ostojaatanasijevic/DS100M08KV2/README.md

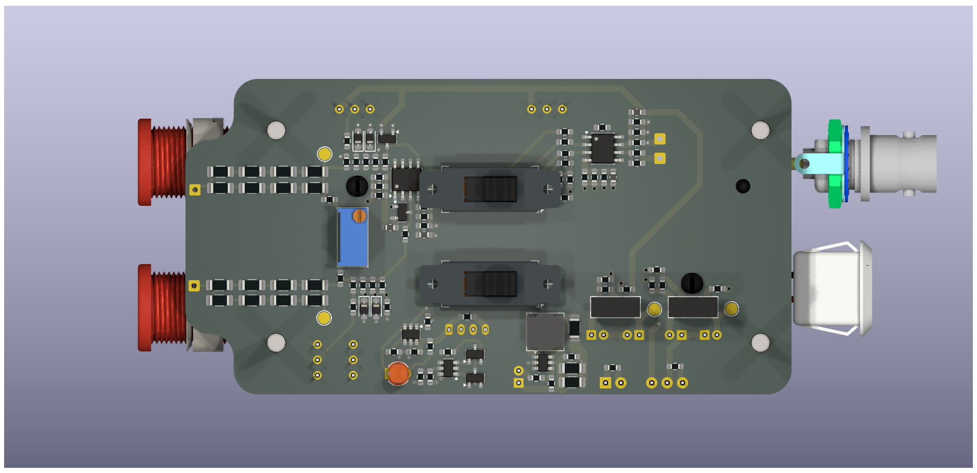
[picture p1: DS100M08KV_top.png]
3D_top

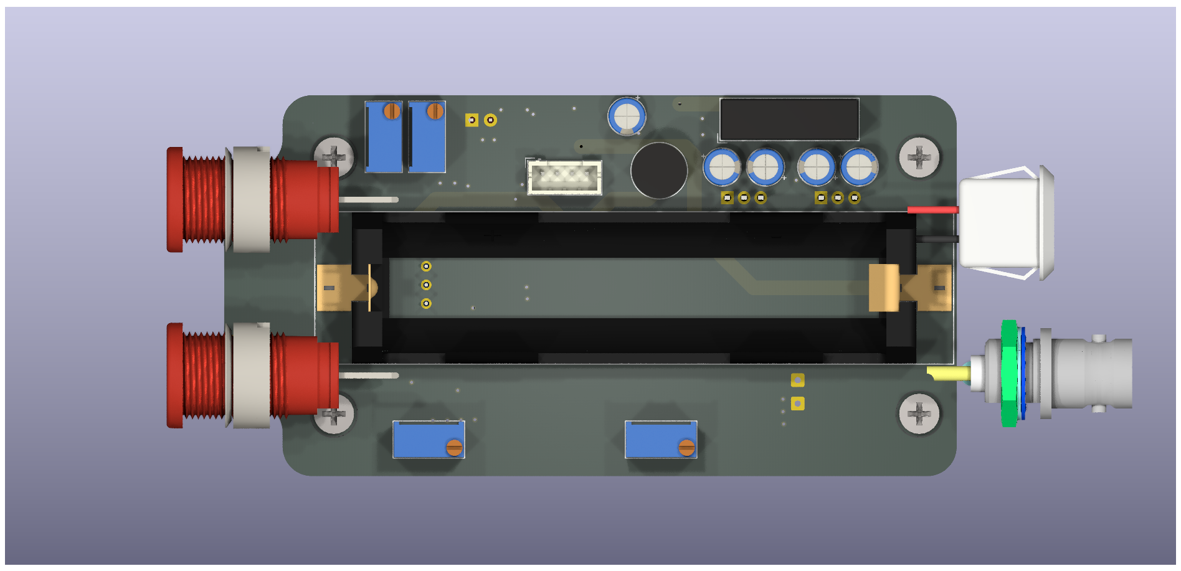
[picture p2: DS100M08KV_bottom.png]
3D_bottom

schematic
