ostojaatanasijevic/DS100M08KV2/documentation/figs/3d_view_top.png

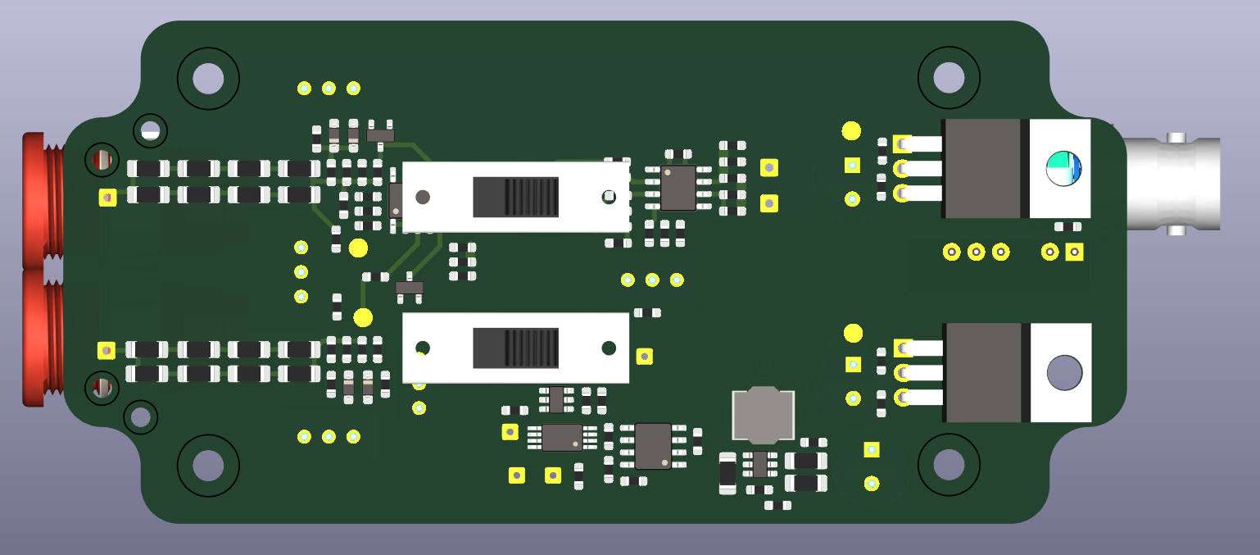
documentation/figs/3d_view_top.png
