ostojaatanasijevic/DS100M08KV2/documentation/figs/case.png

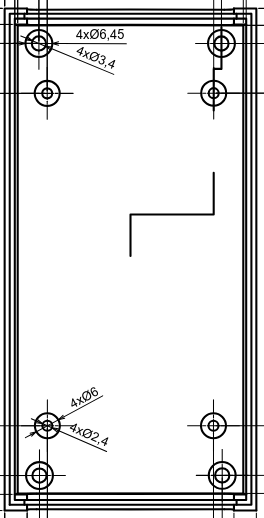
documentation/figs/case.png
