ostojaatanasijevic/DS100M08KV2/documentation/figs/pomona.webp

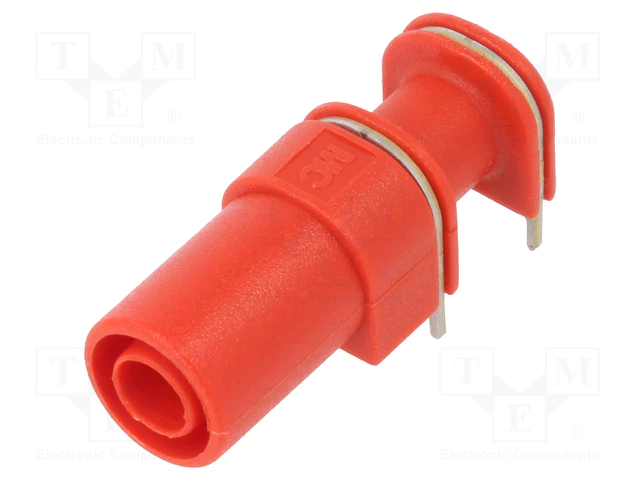
documentation/figs/pomona.webp
