ostojaatanasijevic/DS100M08KV2/BOM.ods

Kurs evra
117.23
Electronics |  | Količina | Po komadu (EUR) | (EUR) | Po komadu RSD | RSD
667-ERJ-PA3J101V | Thick Film Resistors - SMD 0603 100ohm 5% Anti-Surge AEC-Q200 | 2 | 0.035 | 0.07
667-ERA-3AEB103V | Thin Film Resistors - SMD 0603 1/10W 10Kohms 0.1% 25ppm | 10 | 0.087 | 0.87
791-0805N100J501CT | Multilayer Ceramic Capacitors MLCC - SMD/SMT 10pF, +-5%, 500V | 8 | 0.053 | 0.424
80-C0603C105K4PAC | Multilayer Ceramic Capacitors MLCC - SMD/SMT 16V 1uF X5R 0603 10% | 5 | 0.03 | 0.15
603-RT0603BRD0710KL | Thin Film Resistors - SMD 10K ohm 0.1% 1/10W | 2 | 0.063 | 0.126 |  | 0
652-CR0603FX-1000ELF | Thick Film Resistors - SMD 100ohm 1% 1/10W | 2 | 0.005 | 0.01
603-RT0603BRD101KL | Thin Film Resistors - SMD 1K ohm 0.1% 25 ppm Thin Film | 10 | 0.069 | 0.69
603-CC603JRNPO8BN471 | Multilayer Ceramic Capacitors MLCC - SMD/SMT 25 V 470pF C0G 0603 5% | 6 | 0.039 | 0.234
PCB |  | 0.2 | 12 | 2.4 |  | 0
Opamp | https://www.digikey.com/en/products/detail/runic-technology/RS8752XK/14544683?s=N4IgTCBcDaIEoGUAcB2ArBAugXyA | 1 | 0.56 | 0.56
Mehanicals
BNC connector | https://www.mgelectronic.rs/bnc-uti%C4%8Dnica-panel | 1 |  |  | 64.8 | 64.8
4 mm | https://www.aliexpress.com/item/1005005352800055.html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 | 0 | 1.26 | 0 |  | 0
kutija | https://www.mgelectronic.rs/kupl-z98 | 1 | 2.5 | 2.5 | 288 | 288
4 mm mg | https://www.mgelectronic.rs/uti%C4%8Dnica-banana-4mm-mc-crna | 2 |  |  | 198 | 396
USB C |  | 1 |  |  | 100 | 100
Prekidači | https://www.mgelectronic.rs/prekida%C4%8D-klize%C4%87i-tip-02 | 2 |  |  | 64.8 | 129.6
Trim pot | https://www.mgelectronic.rs/potenciometar-trimer-viob-38-w-50r | 3 |  |  | 60 | 180
 |  |  |  |  |  | 0
 |  |  |  | 8.034 |  | 1158.4 | 2100.22582
