ostojaatanasijevic/DS100M08KV2/simulacije/charge_pump/charge_pump_notch_recreation.asc

B1: bv; V= if(time >  start_time, idt(V(vin, vout)*I(R2))/(time - start_time),0)
B2: bv; V=if(time > start_time, -idt(V(vin)*I(V2)) / (time - start_time),0)
B3: bv; V=  V(input_power) - V(output_power)
B4: bv; V= min(max(V(output_power) / V(input_power),0), 1)
C1: cap; 10µ
C2: cap; 10µ
C3: cap; 100n
C4: cap; 100p
C5: cap; 10µ
C6: cap; 100p
C7: cap; 1n
C8: cap; 47µ
C9: cap; 100n
C10: cap; 47µ
D1: diode; 1N4148
D2: diode; 1N4148
D3: diode; 1N4148
D4: diode; 1N4148
D5: diode; 1N4148
D6: diode; 1N4148
M1: pmos; AO6407
M2: nmos; AO4630_N
M3: pmos; AO6407
M4: nmos; AO4630_N
R1: res; 1k
R2: res; 30
R3: res; 10k
R4: res; 39k
R5: res; 80k
R6: res; 80k
R7: res; 4
R8: res; 100m
R9: res; 100m
R10: res; 100m
R11: res; {esr}
U1: SN74HC14
U2: SN74HC14
U3: SN74HC14
U4: SN74HC14
U5: SN74HC14
U6: SN74HC14
V2: voltage; {Vbat}
Named nets: 0, G1, G2, output_power, input_power, efficiency, losses, vin, vout, out
.param fsw 50k
.param d = 0.5
.param Cf = 100u
.tran 2m uic
.lib AO3400.mod
.param Vbat 4.2
.param start_time = 2m
300 kHz peak eff: 98%
.param esr 1m
