ostojaatanasijevic/DS100M08KV2/simulacije/charge_pump/Draft1.asc

D1: LED; NSSW008CT-P1
Q1: npn; 2N2222
R1: res; 50k
V1: voltage; 3.3
V2: voltage; PULSE(0 3.3 0 0 0 100u 1m)
Named nets: 0
.tran 3m
