ostojaatanasijevic/DS100M08KV2/simulacije/charge_pump/tl431.asc

C1: cap; 1µ
C2: cap; 1µ
C3: cap; 1µ
C4: cap; 1µ
C5: cap; 47µ
C6: cap; 47µ
D3: diode; 1N4148
I1: current; 500µ
I2: current; 1m
I3: current; 6m
Q1: npn; 2N3904
Q2: npn; 2N3904
Q3: npn; 2N3904
Q4: npn; 2N3904
Q5: npn; 2N3904
Q6: npn; 2N3904
Q7: pnp; 2N3906
Q8: pnp; 2N3906
Q9: npn; 2N3904
Q10: npn; 2N3904
Q11: npn; 2N3904
Q12: pnp; 2N5401
Q13: pnp; 2N5401
Q14: pnp; 2N5401
Q15: pnp; 2N5401
R1: res; 1k
R2: res; 100
R3: res; 100
R4: res; 1k
R5: res; 40k
R6: res; 30
R7: res; 81k
R8: res; 22k
R9: res; 51k
R10: res; 10k
R11: res; 1k
R12: res; 510k
R13: res; 100k
R14: res; 1k
R15: res; 1k
R16: res; 100k
R17: res; 100k
R18: res; 1k
R19: res; 1m
R20: res; 10k
R21: res; 1m
R22: res; 30
R23: res; 1k
R24: res; 40k
R25: res; 10k
R26: res; 1m
R27: res; 330
R28: res; 1k
R29: res; 10k
R30: res; 1m
R31: res; 1k
R32: res; 10k
R33: res; 1m
R34: res; 680
R35: res; 33
R36: res; 1
R37: res; 30
R38: res; 1k
R39: res; 10k
R40: res; 1m
R41: res; 680
R42: res; 1k
R44: res; 30
U1: AO3401A
U2: AO3401A
U3: TL431
U4: TL431
U5: TL431
V1: voltage; {Vbat}
V2: voltage; {Vbat}
V3: voltage; {Vbat}
V4: voltage; {Vbat}
V5: voltage; {Vbat}
V6: voltage; {Vbat}
V7: voltage; {Vbat}
V8: voltage; PULSE({Vbat - ripple } {Vbat + ripple } 0 0 0 20u 40u)
V10: voltage; PULSE({Vbat - ripple } {Vbat + ripple } 0 0 0 20u 40u)
Named nets: 0, vout+
.param fsw = 40k
.param d = 0.5
.param Cf = 10u
.tran 10m
.lib AO3400.mod
.step param Vbat list 3.5 3.9 4.2
.param ripple = 100m
