ostojaatanasijevic/DS100M08KV2/simulacije/two_opamp/input_capacitance_trimming.asc

C1: cap; 10p
C2: cap; 10p
C3: cap; 10p
C4: cap; 10p
C5: cap; 10p
C6: cap; 10p
C7: cap; 10p
C8: cap; 10p
C10: cap; 108p
C12: cap; 107.84p
C13: cap; 995.5p
C15: cap; 55.5p
C16: cap; 470p
C17: cap; {par_cap}
C18: cap; {par_cap}
C19: cap; 470p
L1: ind; 15n
L2: ind; 15n
L3: ind; 15n
L4: ind; 15n
R1: res; 10k
R2: res; 10k
R3: res; 25
R4: res; 25
R5: res; 1Meg
R6: res; 1Meg
R7: res; 1Meg
R8: res; 1Meg
R9: res; 1Meg
R10: res; 1Meg
R11: res; 1Meg
R12: res; 1Meg
R13: res; 100
R14: res; 100
R15: res; 100
R16: res; 100
R21: res; 92.54k
R22: res; 92.54k
V1: voltage; 2.75
V2: voltage; -2.75
V3: voltage; 10; AC 400
V4: voltage; 9
V6: voltage; -9
V7: voltage; {five}
V8: voltage; {five}
V9: voltage; 10; AC 400
Named nets: 0, 2.5V, -2.5V, 9V, -9V, 5V, -5V
;tran 1m
.param five=5
.param par_cap = 1p
1 / 400
82.5 dB CMRR at 100 kHz
.ac dec 100 100 1000Meg
.lib TLV354.LIB
