ostojaatanasijevic/DS100M08KV2/simulacije/two_opamp/negative_voltage_output.asc

C1: cap; 47µ
C2: cap; 47µ
C3: cap; 10µ
D1: diode; 1N4148
D2: diode; 1N4148
D3: diode; 1N4148
D4: diode; 1N4148
D5: diode; 1N4148
D6: diode; 1N4148
D7: diode; 1N4148
I1: current; 7m
Q1: npn; 2N5551
Q2: npn; 2N5551
Q3: npn; 2N5551
Q4: pnp; 2N5401
Q5: npn; 2N5551
Q6: pnp; 2N5401
R1: res; 100k
R2: res; 1k
R3: res; 500
R4: res; 500
R5: res; 25k
R6: res; 100k
R7: res; 1k
R8: res; 1k
R9: res; 1k
R10: res; 1m
R11: res; 100k
R12: res; 22k
R13: res; 100k
R14: res; 22k
R15: res; 470k
R16: res; 1Meg
R17: res; 1Meg
R18: res; 470k
R58: res; 500
U1: opamp2; TLV354
U2: opamp2; TLV354
U3: opamp2; TLV354
V1: voltage; 2.75
V2: voltage; -2.75
V3: voltage; SINE(2 2.5 1k)
V4: voltage; 9
V5: voltage; SINE(2 2.5 1k)
V6: voltage; -9
V7: voltage; {five}
V8: voltage; {five}
V9: voltage; SINE(-0.25 0.5 10Meg)
V10: voltage; -3.3
V11: voltage; PULSE({Vbat - ripple } {Vbat + ripple } 0 0 0 20u 40u)
V12: voltage; PULSE({Vbat - ripple } {Vbat + ripple } 0 0 0 20u 40u)
Named nets: 0, 2.5V, -2.5V, 9V, -9V, 5V, -5V, vout+, vout-, pos, neg
;tran 1m
.param five=5
.param par_cap = 1p
.lib TLV354.LIB
.tran 10m
.step param Vbat list 3.2 3.5 3.6 3.9 4.2
.param ripple = 100m
