ostojaatanasijevic/DS100M08KV2/simulacije/two_opamp/ratio_analysis.asc

C1: cap; 10p
C2: cap; 10p
C3: cap; 10p
C4: cap; 10p
C5: cap; 10p
C6: cap; 10p
C7: cap; 10p
C8: cap; 10p
C9: cap; 55.5p
C10: cap; 55.5p
C11: cap; 470p
C12: cap; 470p
C13: cap; 470p
C14: cap; 470p
C15: cap; {par_cap}
C16: cap; {par_cap}
C17: cap; {par_cap}
C18: cap; {par_cap}
C37: cap; 10p
C38: cap; 10p
C39: cap; 10p
C40: cap; 10p
C41: cap; 10p
C42: cap; 10p
C43: cap; 10p
C44: cap; 10p
C45: cap; 55.5p
C46: cap; 55.5p
C47: cap; 470p
C48: cap; 470p
C49: cap; 470p
C50: cap; 470p
C51: cap; {par_cap}
C52: cap; {par_cap}
C53: cap; {par_cap}
C54: cap; {par_cap}
L1: ind; 15n
L2: ind; 15n
L3: ind; 15n
L4: ind; 15n
L9: ind; 15n
L10: ind; 15n
L11: ind; 15n
L12: ind; 15n
R1: res; 10k
R2: res; 10k
R3: res; 25
R4: res; 25
R5: res; 1Meg
R6: res; 1Meg
R7: res; 1Meg
R8: res; 1Meg
R9: res; 1Meg
R10: res; 1Meg
R11: res; 1Meg
R12: res; 1Meg
R13: res; 100
R14: res; 100
R15: res; 100
R16: res; 100
R17: res; 500
R18: res; 500
R19: res; 500
R20: res; 500
R21: res; 92.54k
R22: res; 92.54k
R41: res; 10k
R42: res; 10k
R43: res; 25
R44: res; 25
R45: res; 1Meg
R46: res; 1Meg
R47: res; 1Meg
R48: res; 1Meg
R49: res; 1Meg
R50: res; 1Meg
R51: res; 1Meg
R52: res; 1Meg
R53: res; 100
R54: res; 100
R55: res; 100
R56: res; 100
R57: res; 500
R58: res; 500
R59: res; 500
R60: res; 500
U1: opamp2; TLV354
U2: opamp2; TLV354
U3: opamp2; TLV354
U4: opamp2; TLV354
V1: voltage; 2.75
V2: voltage; -2.75
V3: voltage; 10
V4: voltage; 9
V5: voltage; 10
V6: voltage; -9
V7: voltage; {five}
V8: voltage; {five}
V9: voltage; 30
V14: voltage; 500
Named nets: 0, 2.5V, -2.5V, 9V, -9V, 5V, -5V
.tran 1m
.param five=5
.param par_cap = 1p
1 / 400
82.5 dB CMRR at 100 kHz
;ac dec 100 100 1000Meg
.lib TLV354.LIB
1 / 400
82.5 dB CMRR at 100 kHz
;ac dec 100 100 1000Meg
.lib TLV354.LIB
