ostojaatanasijevic/DS100M08KV2/simulacije/charge_pump/complete_linear_regulator.asc

C3: cap; 47µ
C4: cap; 47µ
I1: current; 7m
Q1: npn; 2N5551
Q2: pnp; 2N5401
Q3: npn; 2N5551
Q4: pnp; 2N5401
R1: res; 470k
R2: res; 1k
R3: res; 1Meg
R4: res; 1k
R5: res; 1Meg
R6: res; 470k
R10: res; 1m
R11: res; 100k
R12: res; 100k
R13: res; 22k
R14: res; 22k
V1: voltage; PULSE({Vbat - ripple } {Vbat + ripple } 0 0 0 20u 40u)
V5: voltage; PULSE({Vbat - ripple } {Vbat + ripple } 0 0 0 20u 40u)
Named nets: vout+, vout-, pos, neg, 0
.tran 10m
.step param Vbat list 3.2 3.5 3.6 3.9 4.2
.param ripple = 100m
