ostojaatanasijevic/DS100M08KV2/simulacije/charge_pump/improved_gate_driver.asc

C1: cap; {Cf}
C2: cap; {Cf}
C3: cap; 100n
C9: cap; 100n
D1: schottky; RB480K
D2: schottky; RB480K
M1: pmos; AO6407
M2: nmos; AO4630_N
M3: pmos; AO6407
M4: nmos; AO4630_N
R1: res; 22
R2: res; 100
R3: res; 22
V1: voltage; PULSE(0 4 {1 / fsw / 2 - deadtime} 10n 10n {d / fsw + 2 * deadtime} {1 / fsw})
V2: voltage; {Vbat}
V3: voltage; PULSE(0 4 {1 / fsw / 2} 10n 10n {d / fsw} {1 / fsw})
Named nets: 0
.param fsw = 40k
.param d = 0.5
.param Cf = 10u
.tran 10m
.lib AO3400.mod
.param Vbat 4.2
.param deadtime = 100n
