ostojaatanasijevic/DS100M08KV2/simulacije/charge_pump/logicoscilator.asc

C1: cap; 1n
C2: cap; 100n
D1: diode; 1N4148
D2: diode; 1N4148
E1: e; 1
R1: res; 100k
R2: res; 1Meg
R3: res; 100k
R6: res; 33k
U2: SN74HC14
V5: voltage; 3.6
Named nets: 0, out
.param fsw = 40k
.param d = 0.5
.param Cf = 10u
.tran 1000m uic
.ic V(out) = 3.6
