ostojaatanasijevic/DS100M08KV2/simulacije/charge_pump/oscilator.asc

C1: cap; 100p
C2: cap; 100p
R1: res; 100k
R2: res; 100k
R3: res; 100k
R4: res; 150k
R5: res; 1k
R7: res; 150k
U1: LM339A_TI
U2: 74hc14
V5: voltage; 3.6
Named nets: 0
.param fsw = 40k
.param d = 0.5
.param Cf = 10u
.tran 10m
.param vcc = 3.3
