ostojaatanasijevic/DS100M08KV2/simulacije/switch_placement/ac_analysis.asc

C1: cap; 100f
C2: cap; 470p
C3: cap; 10p
C4: cap; 10p
C5: cap; 10p
C6: cap; 10p
C7: cap; 470p
C8: cap; 470p
C9: cap; 10p
C10: cap; 10p
C11: cap; 10p
C12: cap; 10p
C13: cap; {par_cap}
C14: cap; {par_cap}
C17: cap; 1n
C18: cap; 55.5p
C21: cap; 470p
C22: cap; 55.5p
C23: cap; {par_cap}
C24: cap; {par_cap}
C25: cap; {par_cap}
C26: cap; {par_cap}
C27: cap; {par_cap}
L1: ind; 15n
L2: ind; 15n
L3: ind; 15n
L4: ind; 15n
R1: res; 1Meg
R2: res; 1Meg
R3: res; 1Meg
R4: res; 1Meg
R5: res; 10k
R6: res; 1Meg
R7: res; 1Meg
R8: res; 1Meg
R9: res; 1Meg
R10: res; 10k
R11: res; 25
R12: res; 25
R13: res; 10k
R14: res; 25
R15: res; 1Meg
R16: res; 1Meg
R17: res; 1Meg
R18: res; 1Meg
R19: res; 100
R20: res; 100
R21: res; 100
R22: res; 100
R23: res; 5k
R24: res; {Rf / 200 * gain * (100 + tolerance) / 100}
R25: res; {Rf * (100 - tolerance)/100}
R26: res; {Rf * (100 - tolerance)/100}
R27: res; {Rf / 200 * gain * (100 + tolerance) / 100}
U1: AD8009an
U4: AD8039
U5: AD8039
V1: voltage; 2.75
V2: voltage; -2.75
V3: voltage; ""; AC 100
V4: voltage; 9
V5: voltage; 10
V6: voltage; -9
V7: voltage; {five}
V8: voltage; {five}
V9: voltage; ""; AC 100
V12: voltage; ""; AC 100
Named nets: 0, 2.5V, -2.5V, 9V, -9V, 5V, -5V, diff+, diff-
;tran 0 10m 0 1n
1 / 400
.param five=5
82.5 dB CMRR at 100 kHz
.ac dec 100 100 1000Meg
.param par_cap = 1p
1 / 400
.param tolerance=-1
.param res_tol=-0.1
.param gain=100
.param Rf = 1000
