ostojaatanasijevic/DS100M08KV2/simulacije/two_opamp/dc_analysis.asc

C1: cap; 10p
C2: cap; 470p
C3: cap; 10p
C4: cap; 10p
C5: cap; 10p
C6: cap; 10p
C7: cap; 470p
C8: cap; 470p
C9: cap; 10p
C10: cap; 10p
C11: cap; 10p
C12: cap; 10p
C13: cap; {par_cap}
C14: cap; {par_cap}
C15: cap; 55.5p
C16: cap; 55.5p
C17: cap; 10p
C18: cap; 10p
C19: cap; {par_cap}
C20: cap; {par_cap}
C21: cap; 470p
C22: cap; 10p
C23: cap; 10p
C24: cap; 10p
C25: cap; 10p
C26: cap; 10p
C27: cap; 55.5p
C28: cap; 55.5p
C29: cap; 470p
C30: cap; 470p
C31: cap; 470p
C32: cap; 470p
C33: cap; {par_cap}
C34: cap; {par_cap}
C35: cap; {par_cap}
C36: cap; {par_cap}
C37: cap; 10p
C38: cap; 10p
C39: cap; 10p
C40: cap; 10p
C41: cap; 10p
C42: cap; 10p
C43: cap; 10p
C44: cap; 10p
C45: cap; 55.5p
C46: cap; 55.5p
C47: cap; 470p
C48: cap; 470p
C49: cap; 470p
C50: cap; 470p
C51: cap; {par_cap}
C52: cap; {par_cap}
C53: cap; {par_cap}
C54: cap; {par_cap}
L1: ind; 15n
L2: ind; 15n
L3: ind; 15n
L4: ind; 15n
L5: ind; 15n
L6: ind; 15n
L7: ind; 15n
L8: ind; 15n
L9: ind; 15n
L10: ind; 15n
L11: ind; 15n
L12: ind; 15n
R1: res; 1Meg
R2: res; 1Meg
R3: res; 1Meg
R4: res; 1Meg
R5: res; 10k
R6: res; 1Meg
R7: res; 1Meg
R8: res; 1Meg
R9: res; 1Meg
R10: res; 10k
R11: res; 25
R12: res; 25
R13: res; 10k
R14: res; 10k
R15: res; 25
R16: res; 25
R17: res; 1Meg
R18: res; 1Meg
R19: res; 100
R20: res; 100
R21: res; 100
R22: res; 100
R23: res; 500
R24: res; 500
R25: res; 500
R26: res; 500
R27: res; 1Meg
R28: res; 1Meg
R29: res; 1Meg
R30: res; 1Meg
R31: res; 1Meg
R32: res; 1Meg
R33: res; 100
R34: res; 100
R35: res; 100
R36: res; 100
R37: res; 500
R38: res; 500
R39: res; 500
R40: res; 500
R41: res; 10k
R42: res; 10k
R43: res; 25
R44: res; 25
R45: res; 1Meg
R46: res; 1Meg
R47: res; 1Meg
R48: res; 1Meg
R49: res; 1Meg
R50: res; 1Meg
R51: res; 1Meg
R52: res; 1Meg
R53: res; 100
R54: res; 100
R55: res; 100
R56: res; 100
R57: res; 500
R58: res; 500
R59: res; 500
R60: res; 500
U1: AD8009an
U2: AD8039
U3: AD8039
U5: AD8009an
U6: AD8066
U8: AD8066
V1: voltage; 2.75
V2: voltage; -2.75
V3: voltage; ""; AC 100
V4: voltage; 9
V5: voltage; 10
V6: voltage; -9
V7: voltage; {five}
V8: voltage; {five}
V9: voltage; ""; AC 100
V10: voltage; ""; AC 100
V11: voltage; 10
V12: voltage; ""; AC 100
V13: voltage; ""; AC 100
V14: voltage; 10
V15: voltage; ""; AC 100
Named nets: 0, 2.5V, -2.5V, 5V, -5V, 9V, -9V
;tran 0 10m 0 1n
1 / 400
.param five=5
82.5 dB CMRR at 100 kHz
;ac dec 100 100 1000Meg
.param par_cap = 1p
1 / 400
82.5 dB CMRR at 100 kHz
.ac dec 100 100 1000Meg
1 / 400
82.5 dB CMRR at 100 kHz
;ac dec 100 100 1000Meg
