ostojaatanasijevic/DS100M08KV2/simulacije/charge_pump/complete.asc

B1: bv; V= if(time >  start_time, idt(V(pos, neg)*I(R10))/(time - start_time),0)
B2: bv; V=if(time > start_time, -idt(V(Vbat+, Vbat-)*I(V5)) / (time - start_time),0)
B3: bv; V=  V(input_power) - V(output_power)
B4: bv; V= min(max(V(output_power) / V(input_power),0), 1)
C1: cap; 100p
C3: cap; 1µ
C4: cap; 1µ
C6: cap; {Cf}
C7: cap; {Cf}
C8: cap; 10µ
D8: diode; 1N4148
M2: AO3400
Q1: npn; 2N3904
Q2: pnp; 2N3906
Q3: npn; 2N3904
Q4: pnp; 2N3906
R1: res; 100
R2: res; 1k
R3: res; 100
R4: res; 1k
R5: res; 100k
R6: res; 100k
R7: res; 100k
R8: res; 150k
R9: res; {Rgate}
R10: res; 1m
R11: res; 40k
R12: res; 40k
R13: res; 10k
R14: res; 10k
U1: LM339A_TI
U5: AO3401A
U6: AO3401A
U7: SN74LVC1G08
U8: nmoss; AO3400
V5: voltage; 4.2
Named nets: 0, Vbat+, gate, Vbat-, output_power, input_power, efficiency, losses, vout+, vout-, pos, neg
.param fsw = 40k
.param d = 0.5
.param Cf = 10u
.tran 10m
;.step param Rgate list 50 100 200 400 600
.param start_time = 2m
.param Rgate = 1k
.lib AO3400.mod
