ostojaatanasijevic/DS100M08KV2/simulacije/charge_pump/H-bridge_charge_pump.asc

C6: cap; {Cf}
C7: cap; {Cf}
C8: cap; 100n
D8: schottky; RB480K
I2: current; 50m
M4: nmos; AO4630_N
M6: pmos; AO6407
M7: pmos; AO6407
M8: nmos; AO4630_N
V5: voltage; 3.6
V6: voltage; PULSE(0 3.6 {1 / fsw / 2} 10n 10n {d / fsw} {1 / fsw})
V8: voltage; PULSE(0 5 0 10n 10n {d / fsw} {1 / fsw})
Named nets: 0
.param fsw = 40k
.param d = 0.5
.param Cf = 10u
.tran 10m
