ostojaatanasijevic/DS100M08KV2/simulacije/charge_pump/H-bridge_charge_pump_negative.asc

C2: cap; 1µ
C3: cap; 1µ
C6: cap; {Cf}
C7: cap; {Cf}
C8: cap; 100n
D8: schottky; RB480K
M4: nmos; AO4630_N
M6: pmos; AO6407
M7: pmos; AO6407
M8: nmos; AO4630_N
Q1: npn; 2N3904
Q2: pnp; 2N3906
R1: res; 100
R2: res; 1k
R3: res; 100
R4: res; 1k
V5: voltage; 3.6
V6: voltage; PULSE(0 3.6 {1 / fsw / 2} 10n 10n {d / fsw} {1 / fsw})
Named nets: 0
.param fsw = 40k
.param d = 0.5
.param Cf = 10u
.tran 10m
