ostojaatanasijevic/DS100M08KV2/simulacije/charge_pump/H-bridge_charge_pump_negative_jlc.asc

C2: cap; 1µ
C3: cap; 1µ
C6: cap; {Cf}
C7: cap; {Cf}
C8: cap; 100n
D8: schottky; RB480K
I1: current; 100µ
Q1: npn; 2N3904
Q2: pnp; 2N3906
Q3: npn; 2N3904
Q4: pnp; 2N3906
Q5: npn; 2N3904
Q6: npn; 2N3904
Q7: pnp; 2N3906
Q8: pnp; 2N3906
R1: res; 30
R2: res; 2k
R3: res; 30
R4: res; 2k
R5: res; 51k
R6: res; 10k
R7: res; 51k
R8: res; 10k
R9: res; 510k
R10: res; 100k
R11: res; 1k
R12: res; 510k
R13: res; 100k
R14: res; 1k
R15: res; 1k
R16: res; 100k
R17: res; 100k
U1: AO3401A
U2: AO3401A
U3: nmoss; AO3400
U4: nmoss; AO3400
V1: voltage; {Vbat}
V2: voltage; {Vbat}
V5: voltage; {Vbat}
V6: voltage; PULSE(0 4.2 {1 / fsw / 2} 10n 10n {d / fsw} {1 / fsw})
Named nets: 0
.param fsw = 40k
.param d = 0.5
.param Cf = 10u
.tran 10m
.lib AO3400.mod
.step param Vbat list 3 3.3 3.6 3.9 4.2
