ostojaatanasijevic/DS100M08KV2/simulacije/charge_pump/logic_gate_charge_pump.asc

C1: cap; {Cf}
C2: cap; {Cf}
C3: cap; {Cf}
C4: cap; {Cf}
D1: schottky; RB160MM-60
D2: schottky; RB160MM-60
D3: schottky; RB160MM-60
D4: schottky; RB160MM-60
I1: current; 10m
R1: res; 100
U1: SN74LVC1G08
U2: SN74LVC1G08
U3: SN74LVC1G08
U4: SN74LVC1G08
U5: SN74LVC1G08
U6: SN74LVC1G08
U7: SN74LVC1G08
U8: SN74LVC1G08
U9: SN74LVC1G08
U10: SN74LVC1G08
U11: SN74LVC1G08
U12: SN74LVC1G08
V1: voltage; 4
V2: voltage; PULSE(0 5 {1 / fsw / 2} 10n 10n {d / fsw} {1 / fsw})
V3: voltage; PULSE(0 12 10u 10n 10n 30u 10m 1)
V4: voltage; PULSE(0 5 {1 / fsw / 2} 10n 10n {d / fsw} {1 / fsw})
V7: voltage; 310
V9: voltage; PULSE(0 5 10u 10n 10n 1m 10m)
Named nets: 0, input, source, init, 5V
.tran 0 2m 0
.param R_led = 100
.param R_opto = 1k
.param R_load = 2
.param R_GK = 330
.param R_GK_PT = 10k
.param R_gate = 1k
.param Lleak = 1.95u
.param k = sqrt((Lm - Lleak) / Lm)
.param fsw = 100k
.param d = 0.5
.param Lm = 563u
.param Cf = 10u
