ostojaatanasijevic/DS100M08KV2/simulacije/charge_pump/pmos_nmos.asc

C1: cap; {Cf}
C2: cap; {Cf}
C3: cap; {Cf}
C4: cap; {Cf}
C6: cap; {Cf}
C7: cap; {Cf}
C8: cap; 100n
D1: schottky; RB160MM-60
D2: schottky; RB160MM-60
D3: schottky; RB160MM-60
D4: schottky; RB160MM-60
D8: schottky; RB480K
I1: current; 10m
I2: current; 10m
M1: nmos; AO4630_N
M2: pmos; AO6407
M4: nmos; AO4630_N
M6: pmos; AO6407
M7: pmos; AO6407
M8: nmos; AO4630_N
R1: res; 100
U1: SN74LVC1G08
U2: SN74LVC1G08
U3: SN74LVC1G08
U4: SN74LVC1G08
U5: SN74LVC1G08
U6: SN74LVC1G08
V1: voltage; 5
V2: voltage; PULSE(0 5 {1 / fsw / 2} 10n 10n {d / fsw} {1 / fsw})
V3: voltage; PULSE(0 12 10u 10n 10n 30u 10m 1)
V4: voltage; PULSE(0 5 {1 / fsw / 2} 10n 10n {d / fsw} {1 / fsw})
V5: voltage; 3.6
V6: voltage; PULSE(0 3.6 {1 / fsw / 2} 10n 10n {d / fsw} {1 / fsw})
V7: voltage; 310
V8: voltage; PULSE(0 5 0 10n 10n {d / fsw} {1 / fsw})
V9: voltage; PULSE(0 5 10u 10n 10n 1m 10m)
Named nets: 0, input, source, init, 5V
.tran 0 5m 0
.param R_led = 100
.param R_opto = 1k
.param R_load = 2
.param R_GK = 330
.param R_GK_PT = 10k
.param R_gate = 1k
.param Lleak = 1.95u
.param k = sqrt((Lm - Lleak) / Lm)
.param fsw = 10k
.param d = 0.5
.param Lm = 563u
.param Cf = 10u
