ostojaatanasijevic/DS100M08KV2/DS100M08KV2.kicad_pcb

## KiCad design DS100M08KV2.kicad_pcb (2025-10-31)

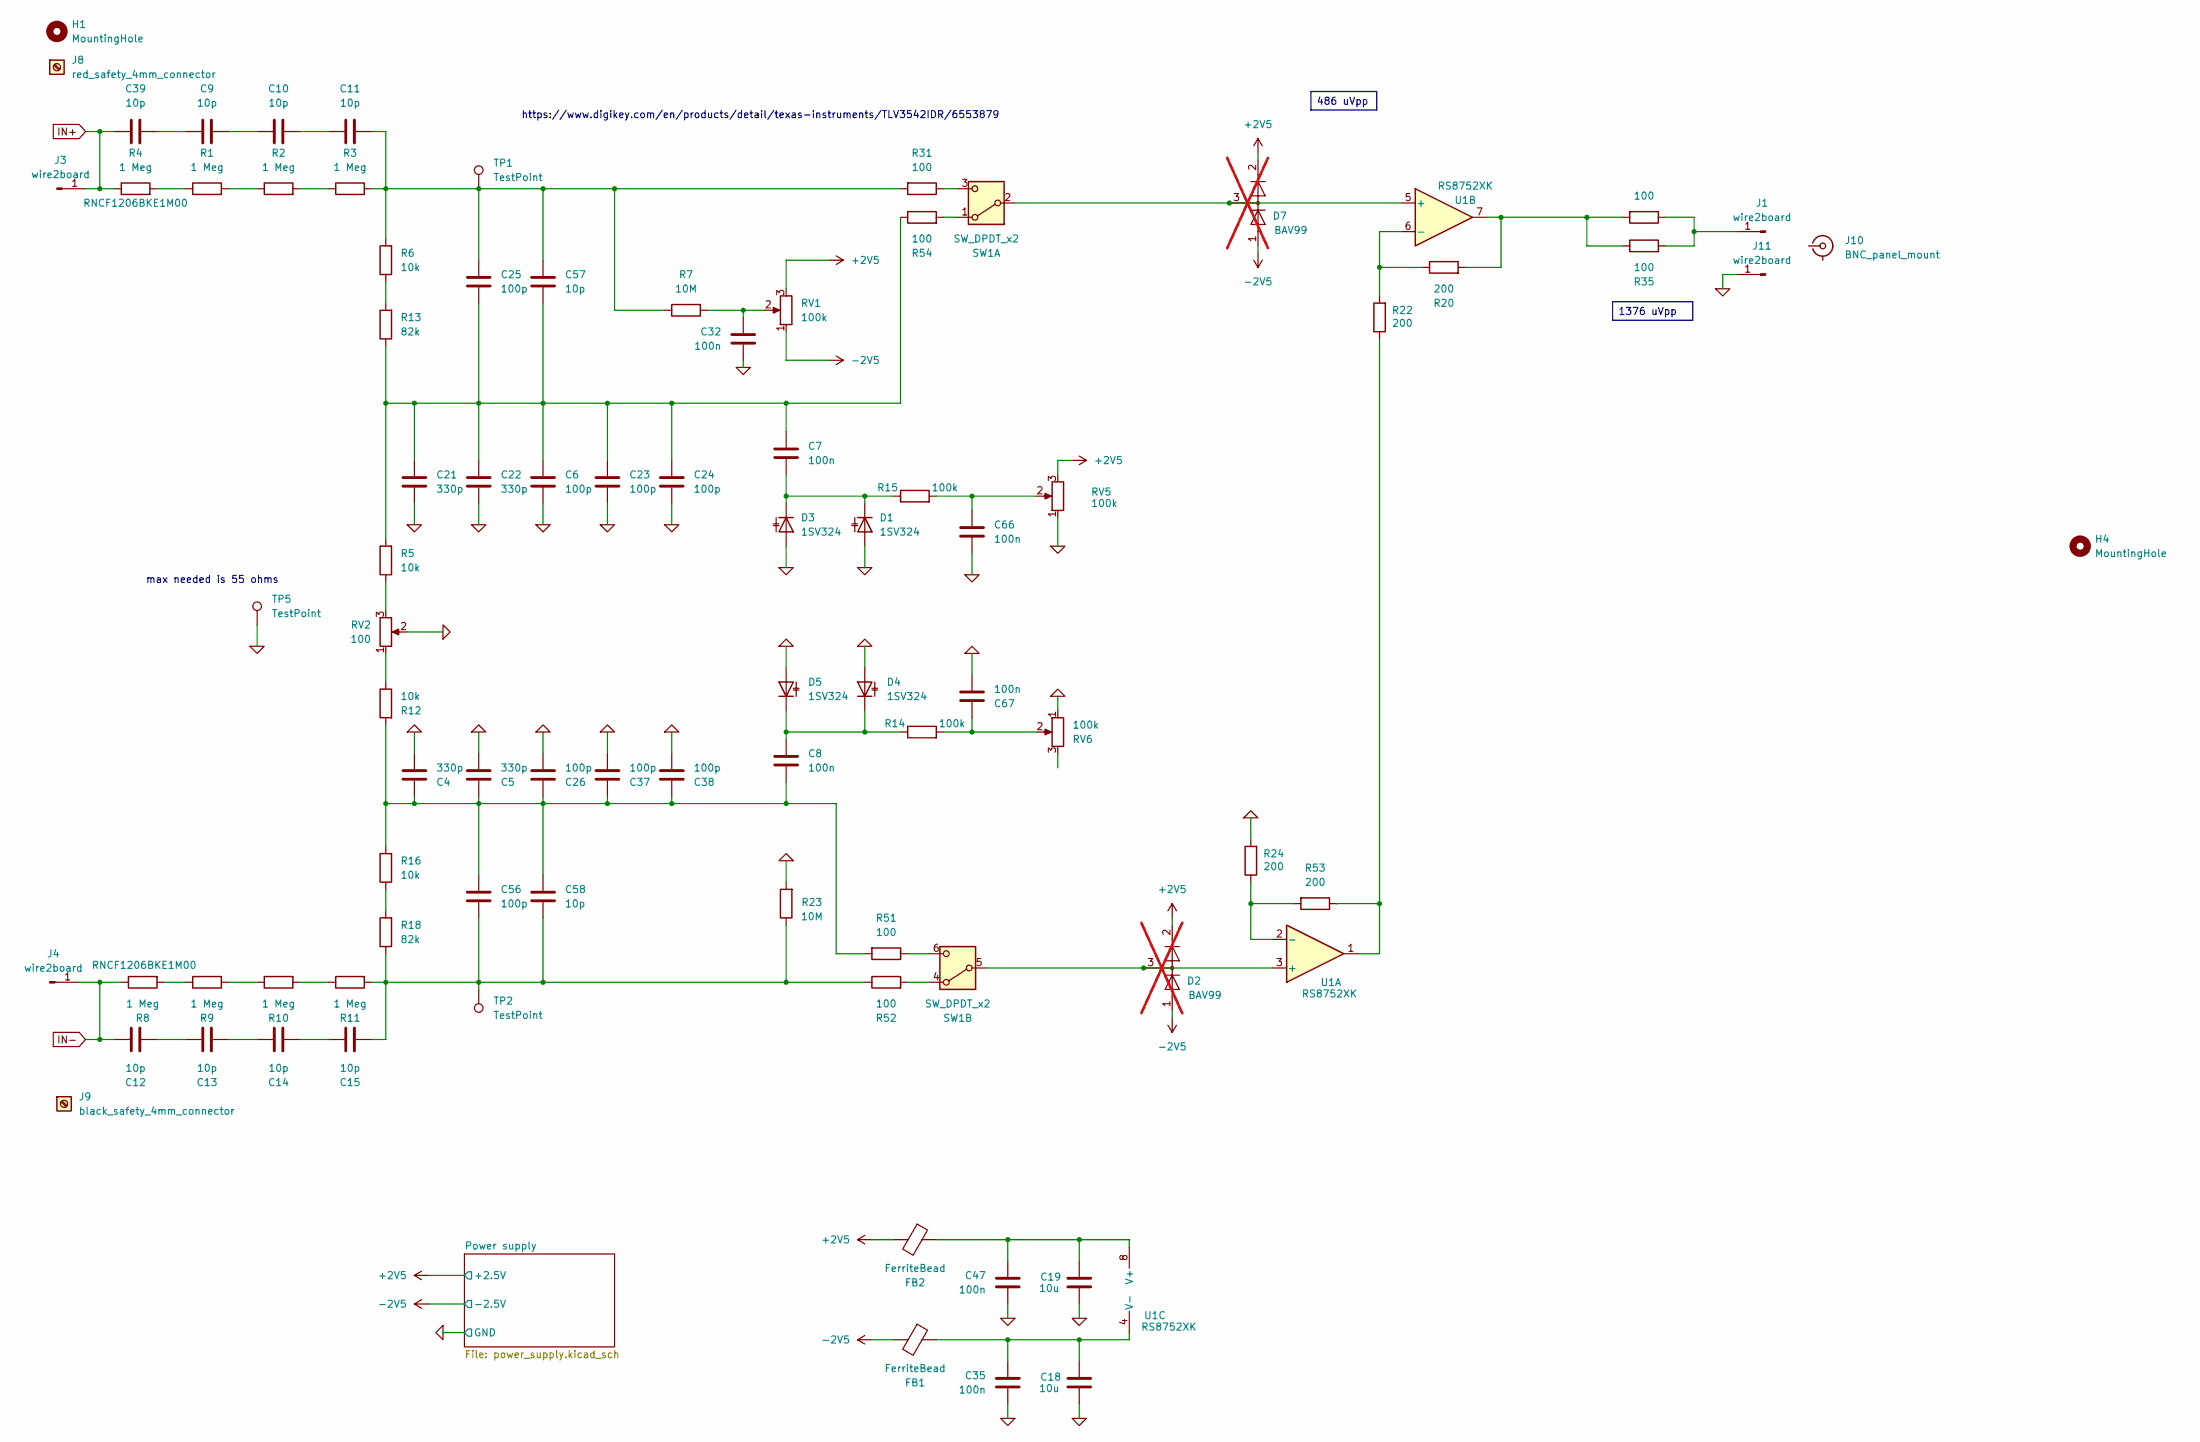
[picture p8: schematic DS100M08KV2.kicad_sch, 1:200 800V 100 MHz differential probe]

Parts:
C4, C5, C21, C22: 330p; R_0603_1608Metric_Pad0.98x0.95mm_HandSolder; LCSC C1664
C6, C23, C24, C25, C26, C37, C38, C56: 100p; R_0603_1608Metric_Pad0.98x0.95mm_HandSolder; LCSC C14858
C7, C8, C32, C35, C47, C66, C67: 100n; C_0603_1608Metric_Pad1.08x0.95mm_HandSolder; LCSC C14663
C9, C10, C11, C12, C13, C14, C15, C39: 10p; R_1206_3216Metric_Pad1.30x1.75mm_HandSolder
C18, C19: 10u; C_0603_1608Metric_Pad1.08x0.95mm_HandSolder; LCSC C96446
C57, C58: 10p; R_0603_1608Metric_Pad0.98x0.95mm_HandSolder; LCSC C1634
D1, D3, D4, D5: 1SV324; D_SOD-323_HandSoldering
D2, D7: BAV99; SOT-23; LCSC C2500; not fitted
FB1, FB2: FerriteBead; L_0603_1608Metric_Pad1.05x0.95mm_HandSolder
H1, H4: MountingHole; M3_with_screw
J1, J3, J4, J11: wire2board; SolderWire-0.25sqmm_1x01_D0.65mm_OD1.7mm
J8: red_safety_4mm_connector; black_safety_4mm_connector
J9: black_safety_4mm_connector
J10: BNC_panel_mount
R1, R2, R3, R9, R10, R11: 1 Meg; R_1206_3216Metric_Pad1.30x1.75mm_HandSolder
R4, R8: 1 Meg; R_1206_3216Metric_Pad1.30x1.75mm_HandSolder; Partnumber RNCF1206BKE1M00
R5, R6, R12, R16: 10k; R_0603_1608Metric_Pad0.98x0.95mm_HandSolder
R7, R23: 10M; R_0603_1608Metric_Pad0.98x0.95mm_HandSolder; LCSC C7250
R13, R18: 82k; R_0603_1608Metric_Pad0.98x0.95mm_HandSolder
R14, R15: 100k; R_0603_1608Metric_Pad0.98x0.95mm_HandSolder; LCSC C25803
R17, R31, R35, R51, R52, R54: 100; R_0603_1608Metric_Pad0.98x0.95mm_HandSolder; LCSC C22775
R20, R22, R24, R53: 200; R_0603_1608Metric_Pad0.98x0.95mm_HandSolder
RV1, RV5, RV6: 100k; Potentiometer_Bourns_3296W_Vertical
RV2: 100; Potentiometer_Bourns_3296W_Vertical
SW1: SW_DPDT_x2; DPDT_bigger
TP1, TP2, TP5: TestPoint; TestPoint_Pad_D2.0mm
U1: RS8752XK; SOIC-8_3.9x4.9mm_P1.27mm; LCSC RS8752XK

Connections:
0: C4.2, C5.2, C6.1, C18.2, C19.2, C21.2, C22.2, C23.1, C24.1, C26.1, C32.1, C35.1, C37.1, C38.1, C47.1, C66.1, C67.1, D1.2 (A), D3.2 (A), D4.2 (A), D5.2 (A), J11.1, R23.2, R24.2, RV2.2, RV5.1, RV6.1, TP5.1; also elsewhere on the board
+2V5: D2.2 (A), D7.2 (A), FB2.2, RV1.3, RV5.3; also elsewhere on the board
-2V5: D2.1 (K), D7.1 (K), FB1.2, RV1.1; also elsewhere on the board
IN+: C39.2, J3.1, R4.1
IN-: C12.2, J4.1, R8.1
unnamed: C10.1, C11.2
unnamed: C9.1, C10.2
unnamed: C11.1, C25.2, C57.2, R3.2, R6.2, R7.1, R31.2, TP1.1
unnamed: C12.1, C13.2
unnamed: C13.1, C14.2
unnamed: C14.1, C15.2
unnamed: C15.1, C56.1, C58.1, R11.2, R18.1, R23.1, R52.1, TP2.1
unnamed: C6.2, C7.2, C21.1, C22.1, C23.2, C24.2, C25.1, C57.1, R5.2, R13.1, R54.1
unnamed: C4.1, C5.1, C8.1, C26.2, C37.2, C38.2, C56.2, C58.2, R12.2, R16.2, R51.2
unnamed: C32.2, R7.2, RV1.2
unnamed: C9.2, C39.1
unnamed: C66.2, R15.2, RV5.2
unnamed: C67.2, R14.2, RV6.2
unnamed: C7.1, D1.1 (K), D3.1 (K), R15.1
unnamed: C8.2, D4.1 (K), D5.1 (K), R14.1
unnamed: J1.1, R17.1, R35.2
unnamed: R1.1, R4.2
unnamed: R1.2, R2.1
unnamed: R2.2, R3.1
unnamed: R5.1, RV2.3
unnamed: R8.2, R9.1
unnamed: R9.2, R10.1
unnamed: R10.2, R11.1
unnamed: R12.1, RV2.1
unnamed: R6.1, R13.2
unnamed: R16.1, R18.2
unnamed: R17.2, R20.2, R35.1, U1.7
unnamed: R22.1, R53.1, U1.1
unnamed: R54.2, SW1.1 (A)
unnamed: D7.3 (K), SW1.2 (B), U1.5 (+)
unnamed: R31.1, SW1.3 (C)
unnamed: R52.2, SW1.4 (A)
unnamed: D2.3 (K), SW1.5 (B), U1.3 (+)
unnamed: R51.1, SW1.6 (C)
unnamed: R24.1, R53.2, U1.2 (-)
unnamed: R20.1, R22.2, U1.6 (-)
unnamed: C19.1, C47.2, FB2.1, U1.8 (V+)
unnamed: C18.1, C35.2, FB1.1, U1.4 (V-)

Notes on the sheet:
https://www.digikey.com/en/products/detail/texas-instruments/TLV3542IDR/6553879
max needed is 55 ohms
1376 uVpp
486 uVpp

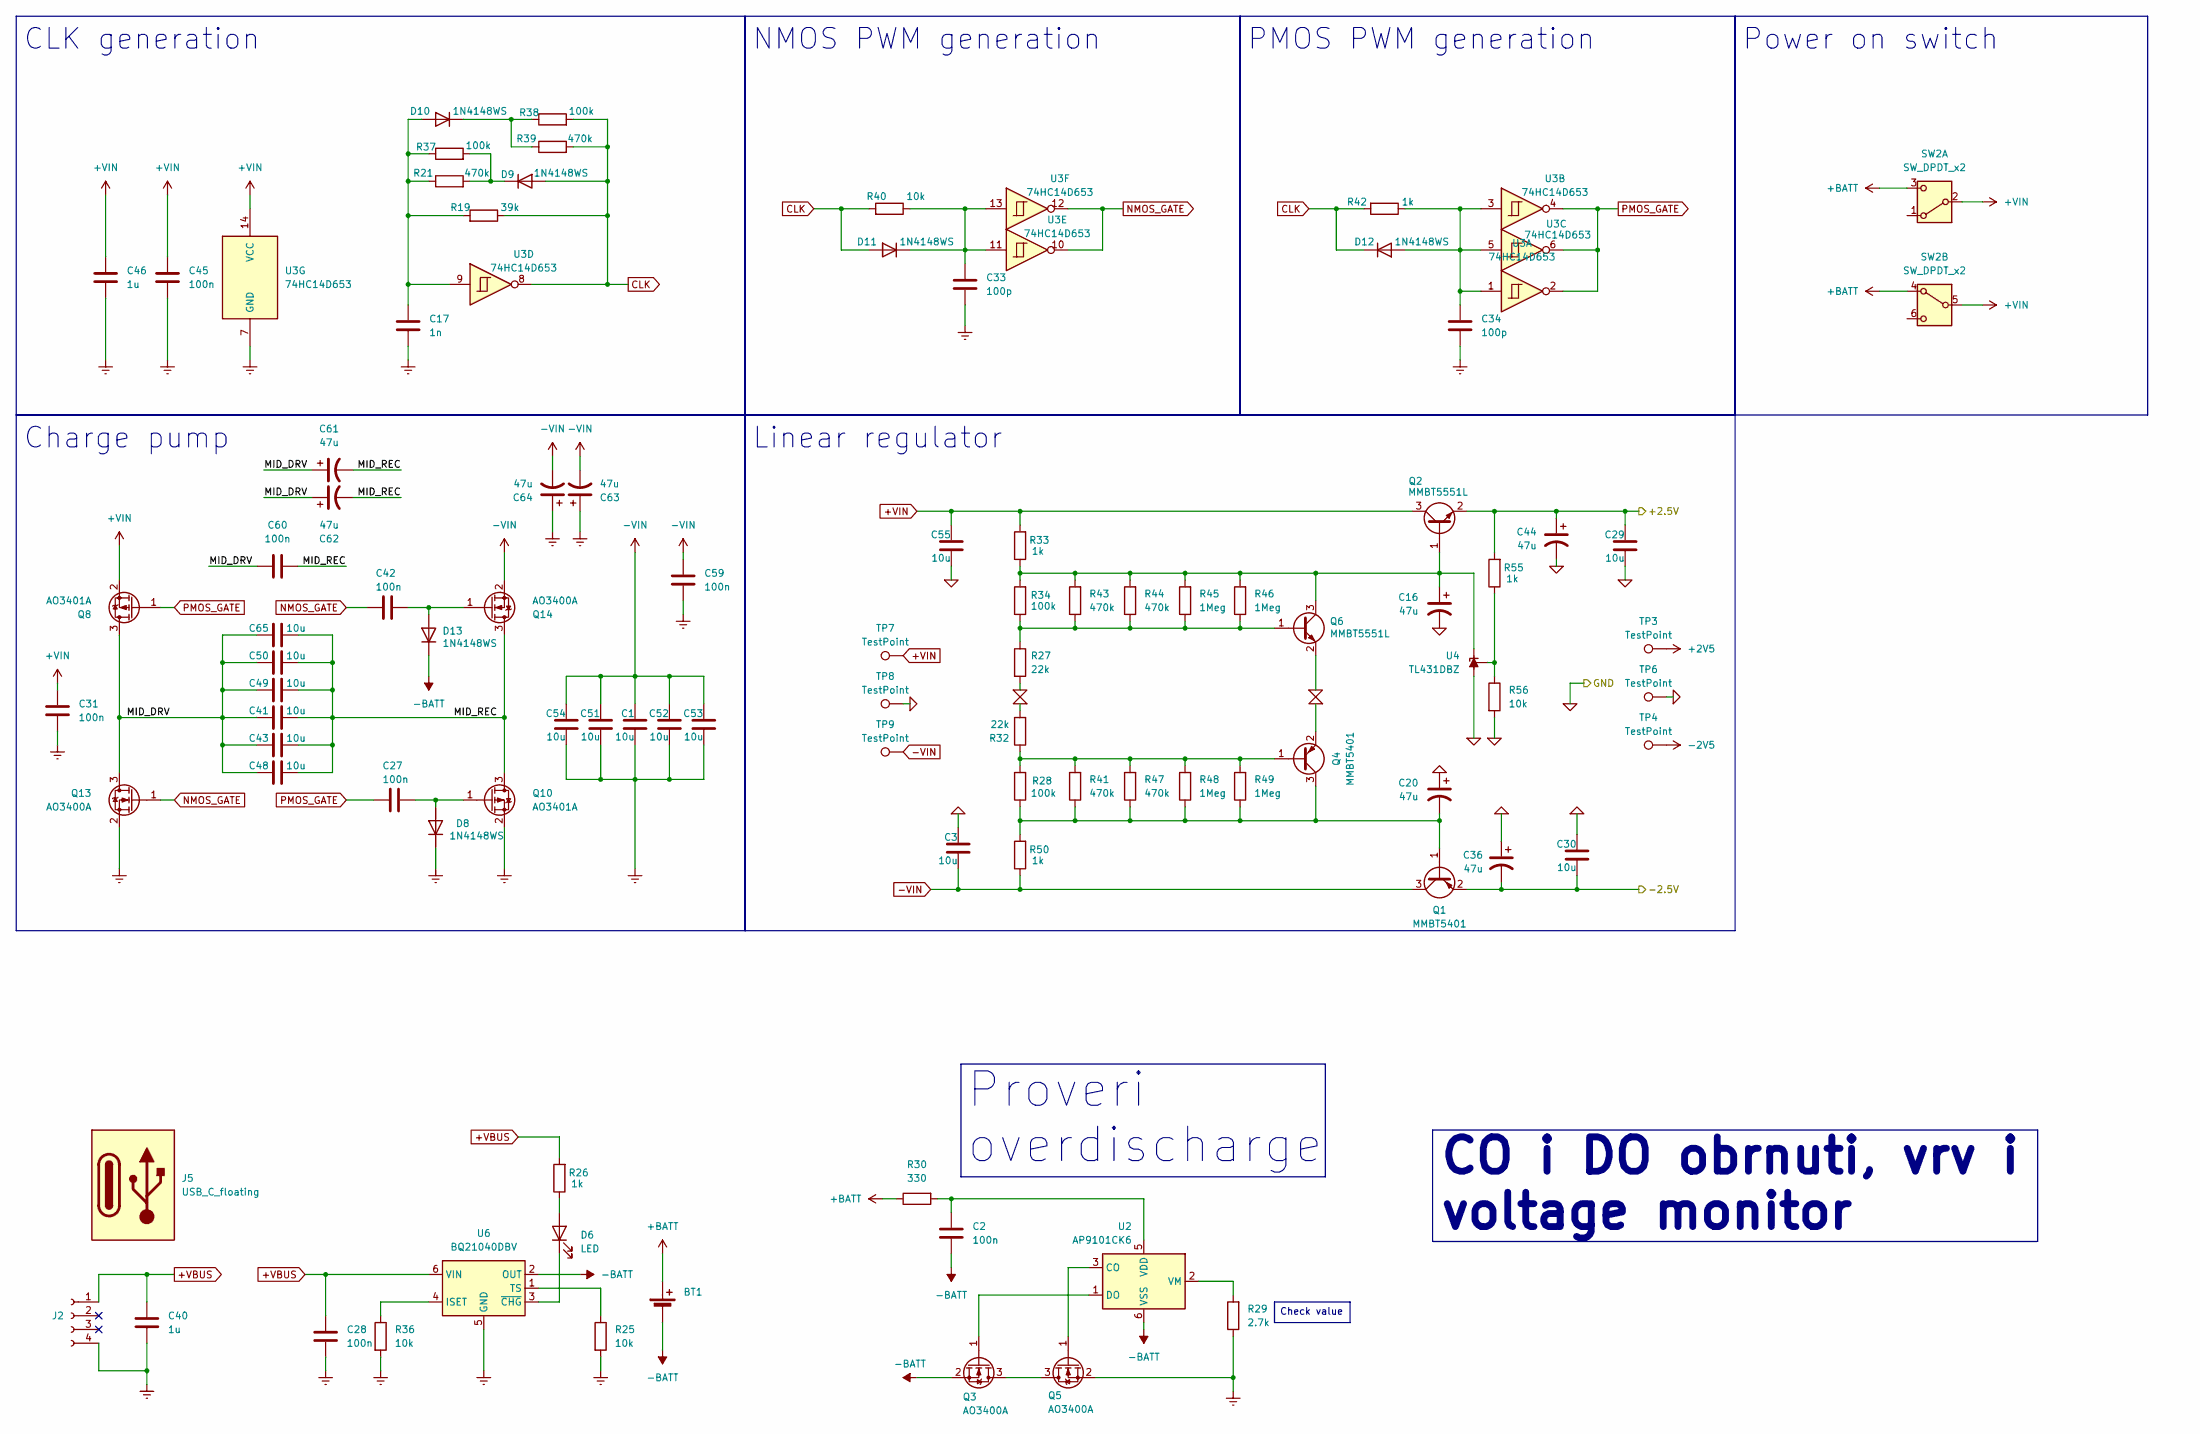
[picture p9: schematic power_supply.kicad_sch]

Parts:
BT1: Battery_Cell; battery_holder
C1, C3, C29, C30, C41, C43, C48, C49, C50, C51, C52, C53, C54, C55, C65: 10u; R_0805_2012Metric_Pad1.20x1.40mm_HandSolder; Voltage 25V; LCSC C15850
C2, C27, C28, C31, C42, C45, C59, C60: 100n; C_0603_1608Metric_Pad1.08x0.95mm_HandSolder; LCSC C14663
C16, C20, C36, C44, C61, C62, C63, C64: 47u; CP_Radial_D5.0mm_P2.00mm
C17: 1n; C_0603_1608Metric_Pad1.08x0.95mm_HandSolder; LCSC C1588
C33, C34: 100p; C_0603_1608Metric_Pad1.08x0.95mm_HandSolder; LCSC C14858
C40, C46: 1u; C_0603_1608Metric_Pad1.08x0.95mm_HandSolder; LCSC C15849
D6: LED; LED_D3.0mm_FlatTop
D8, D9, D10, D11, D12, D13: 1N4148WS; D_SOD-323; LCSC C2128
J2: Conn_01x04_Socket; JST_PH_B4B-PH-K_1x04_P2.00mm_Vertical
J5: USB_C_floating
Q1, Q4: MMBT5401; SOT-23; LCSC C8326
Q2, Q6: MMBT5551L; SOT-23; LCSC C2145
Q3, Q5, Q13, Q14: AO3400A; SOT-23; LCSC C20917
Q8, Q10: AO3401A; SOT-23; LCSC C15127
R19: 39k; R_0603_1608Metric_Pad0.98x0.95mm_HandSolder; LCSC C23153
R21, R39, R41, R43, R44, R47: 470k; R_0603_1608Metric_Pad0.98x0.95mm_HandSolder; LCSC C23178
R25, R36, R40, R56: 10k; R_0603_1608Metric_Pad0.98x0.95mm_HandSolder; LCSC C25804
R26, R33, R42, R50, R55: 1k; R_0603_1608Metric_Pad0.98x0.95mm_HandSolder; LCSC C21190
R27, R32: 22k; R_0603_1608Metric_Pad0.98x0.95mm_HandSolder; LCSC C31850
R28, R34, R37, R38: 100k; R_0603_1608Metric_Pad0.98x0.95mm_HandSolder; LCSC C25803
R29: 2.7k; R_0603_1608Metric_Pad0.98x0.95mm_HandSolder; LCSC C13167
R30: 330; R_0603_1608Metric_Pad0.98x0.95mm_HandSolder; LCSC C23138
R45, R46, R48, R49: 1Meg; R_0603_1608Metric_Pad0.98x0.95mm_HandSolder; LCSC C22935
SW2: SW_DPDT_x2; DPDT_bigger
TP3, TP4, TP6, TP7, TP8, TP9: TestPoint; TestPoint_Pad_D2.0mm
U2: AP9101CK6; SOT-23-6
U3: 74HC14D653; SOIC-14_3.9x8.7mm_P1.27mm; LCSC C5605
U4: TL431DBZ; SOT-23; LCSC C3113
U6: BQ21040DBV; SOT-23-6

Connections:
0: C3.2, C16.2, C20.1, C29.1, C30.2, C36.1, C44.2, C55.1, Q4.2 (E), Q6.2 (E), R27.2, R32.2, R56.2, TP6.1, TP8.1, U4.3 (A); also elsewhere on the board
+2V5: C29.2, C44.1, Q2.2 (E), R55.2, TP3.1; also elsewhere on the board
+BATT: BT1.1 (+), R30.1, SW2.3 (C), SW2.4 (A)
+VBUS: C28.2, C40.2, J2.1, R26.2, U6.6 (VIN)
+VIN: C31.2, C45.2, C46.2, C55.2, Q2.3 (C), Q8.2 (S), R33.2, SW2.2 (B), SW2.5 (B), TP7.1, U3.14 (VCC)
-2V5: C30.1, C36.2, Q1.2 (E), TP4.1; also elsewhere on the board
-BATT: BT1.2 (-), C2.1, D13.1 (K), Q3.2 (S), U2.6 (VSS), U6.2 (OUT)
-VIN: C1.2, C3.1, C51.2, C52.2, C53.2, C54.2, C59.2, C63.2, C64.2, Q1.3 (C), Q14.2 (S), R50.1, TP9.1
/Power supply/MID_DRV: C41.1, C43.1, C48.1, C49.1, C50.1, C60.2, C61.1, C62.1, C65.1, Q8.3 (D), Q13.3 (D)
/Power supply/MID_REC: C41.2, C43.2, C48.2, C49.2, C50.2, C60.1, C61.2, C62.2, C65.2, Q10.3 (D), Q14.3 (D)
CLK: D9.2 (A), D11.2 (A), D12.1 (K), R19.1, R38.2, R39.2, R40.2, R42.2, U3.8
Earth: C1.1, C17.1, C28.1, C31.1, C33.1, C34.1, C40.1, C45.1, C46.1, C51.1, C52.1, C53.1, C54.1, C59.1, C63.1, C64.1, D8.1 (K), J2.4, Q5.2 (S), Q10.2 (S), Q13.2 (S), R25.2, R29.1, R36.2, U3.7 (GND), U6.5 (GND)
NMOS_GATE: C42.1, Q13.1 (G), U3.10, U3.12
unnamed: D6.2 (A), R26.1
unnamed: D6.1 (K), U6.3 (~CHG)
unnamed: C27.2, D8.2 (A), Q10.1 (G)
unnamed: D9.1 (K), R21.2, R37.2
unnamed: C17.2, D10.2 (A), R19.2, R21.1, R37.1, U3.9
unnamed: D10.1 (K), R38.1, R39.1
unnamed: C33.2, D11.1 (K), R40.1, U3.11, U3.13
unnamed: C34.2, D12.2 (A), R42.1, U3.1, U3.3, U3.5
unnamed: C42.2, D13.2 (A), Q14.1 (G)
unnamed: C20.2, Q1.1 (B), Q4.3 (C), R28.1, R41.1, R47.1, R48.1, R49.1, R50.2
unnamed: C16.1, Q2.1 (B), Q6.3 (C), R33.1, R34.2, R43.2, R44.2, R45.2, R46.2, U4.1 (K)
unnamed: Q3.3 (D), Q5.3 (D)
unnamed: Q3.1 (G), U2.1 (DO)
unnamed: Q4.1 (B), R28.2, R32.1, R41.2, R47.2, R48.2, R49.2
unnamed: Q5.1 (G), U2.3 (CO)
unnamed: Q6.1 (B), R27.1, R34.1, R43.1, R44.1, R45.1, R46.1
unnamed: C2.2, R30.2, U2.5 (VDD)
unnamed: R29.2, U2.2 (VM)
unnamed: R55.1, R56.1, U4.2 (REF)
unnamed: R36.1, U6.4 (ISET)
unnamed: R25.1, U6.1 (TS)
PMOS_GATE: C27.1, Q8.1 (G), U3.2, U3.4, U3.6

Notes on the sheet:
Charge pump
CLK generation
Power on switch
Linear regulator
PMOS PWM generation
NMOS PWM generation
Proveri overdischarge
Check value
CO i DO obrnuti, vrv i voltage monitor

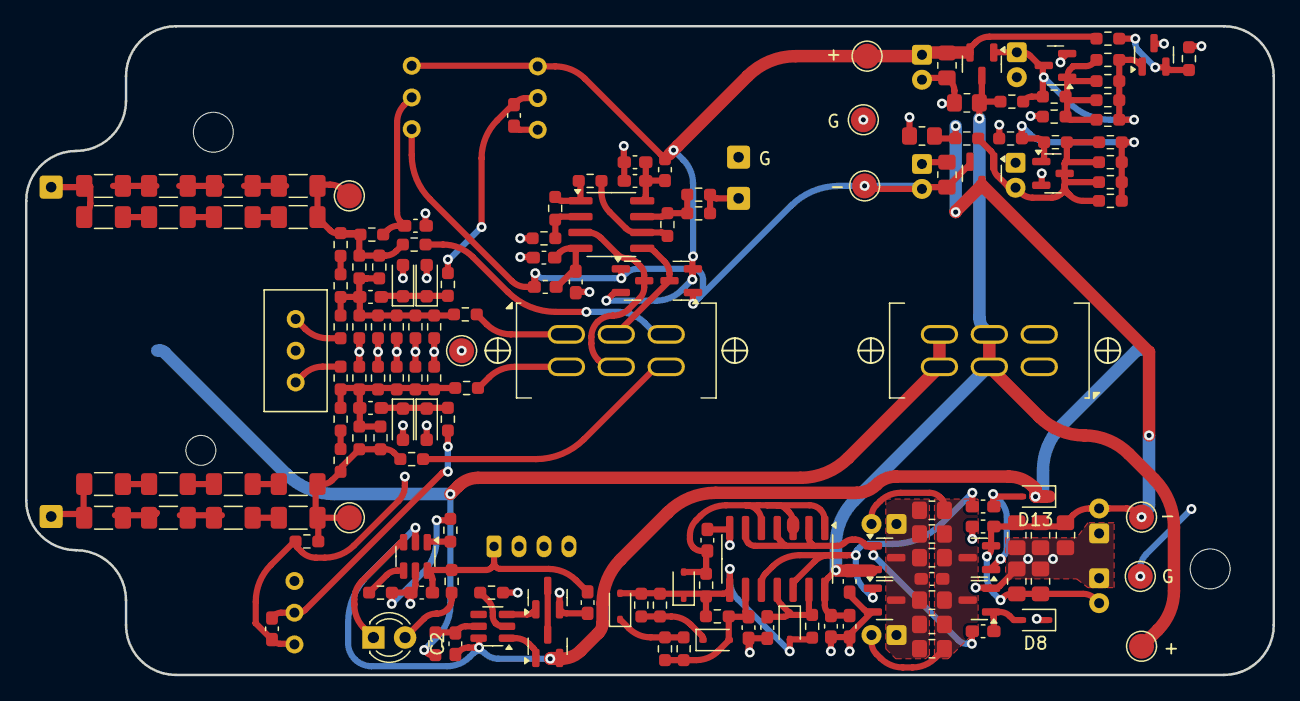
[picture p10: board DS100M08KV2.kicad_pcb from above]

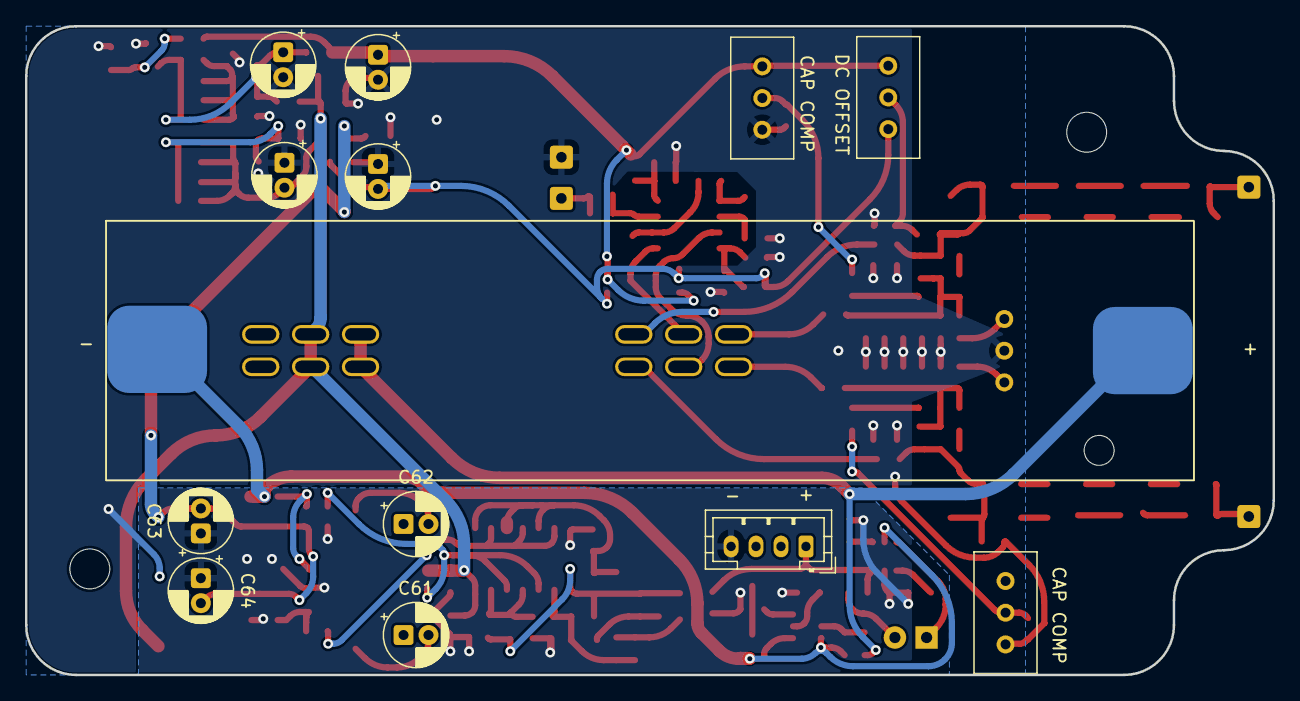
[picture p11: board DS100M08KV2.kicad_pcb from below]

Board: 2 copper layers, 100.0 x 52.0 mm, 180 parts (19 on the bottom side), 75 nets.
