ostojaatanasijevic/DS100M08KV2/(commit log)

2025-10-24 new osc.
    [DS100M08KV2.kicad_sch]
2025-10-25 New sims, added switcher to PCB.
    [DS100M08KV2.kicad_pcb, DS100M08KV2.kicad_sch, power_supply.kicad_sch]
2025-10-27 Sims, schem.
    [DS100M08KV2.kicad_pcb, DS100M08KV2.kicad_sch]
2025-10-27 Placement done.
    [DS100M08KV2.kicad_pcb, DS100M08KV2.kicad_sch, power_supply.kicad_sch]
2025-10-27 Switcher done.
    [DS100M08KV2.kicad_pcb, power_supply.kicad_sch]
2025-10-28 Lin Reg.
    [DS100M08KV2.kicad_pcb, power_supply.kicad_sch]
2025-10-28 Almost done.
    [DS100M08KV2.kicad_pcb, power_supply.kicad_sch]
2025-10-28 Skoro gotovo Skoro gotovo
    [DS100M08KV2.kicad_pcb]
